mamadouxxx/shield_u575/fabrication/v1/assemblage/shield_u575_BOM_JLCPCB.csv

Comment | Designator | Footprint | LCSC Part #
1uF 0805 | C1,C2,C5,C9 | 0805
100nF 0805 | C3,C6,C8 | 0805
4.7uF 0805 | C4 | 0805
10uF 0805 | C7 | 0805
56k 0805 | R1,R2 | 0805
100k 0805 | R3,R10 | 0805
10k 0805 | R5 | 0805
4.7k 0805 | R6,R7,R8,R9 | 0805
TPS22810DBVR | U2 | SOT-23-6
