mamadouxxx/shield_u575/SCD30/SCD30.step

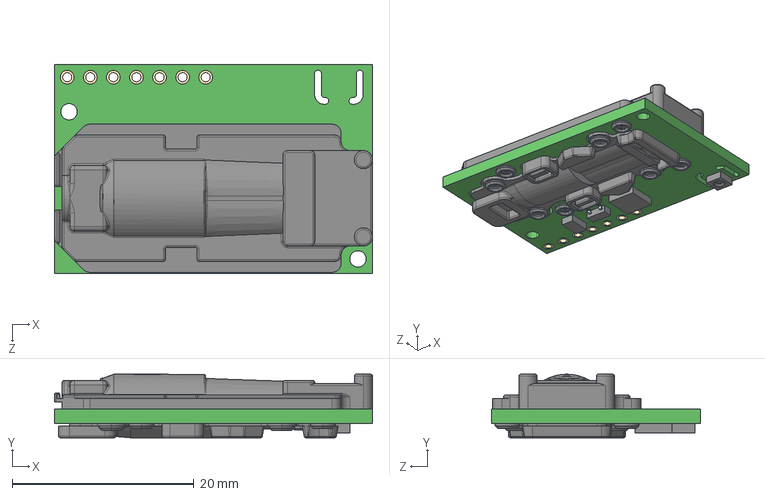
[picture p3: CAD file, 2026-11-06]
SCD30/SCD30.step
35.0 x 7.00 x 23.0 mm
