mamadouxxx/shield_u575/TPS22810DBVR/TPS22810DBVR.step

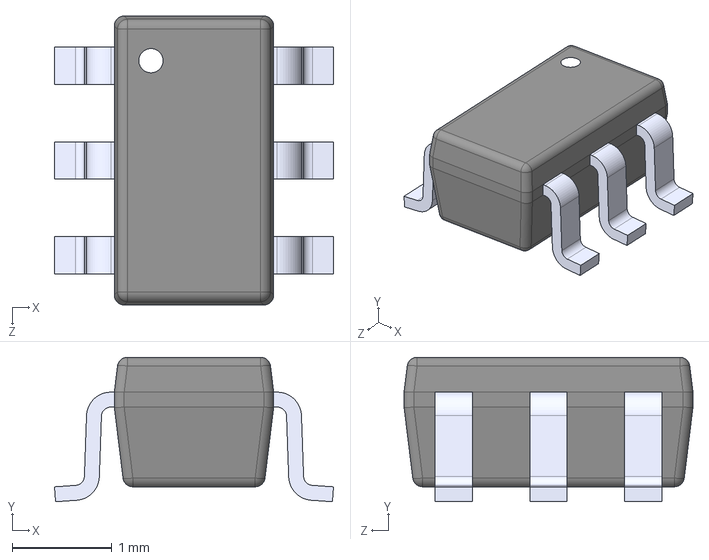
[picture p4: CAD file, 2026-11-06]
TPS22810DBVR/TPS22810DBVR.step
2.80 x 1.45 x 2.90 mm
