mamadouxxx/shield_u575/schema.pdf

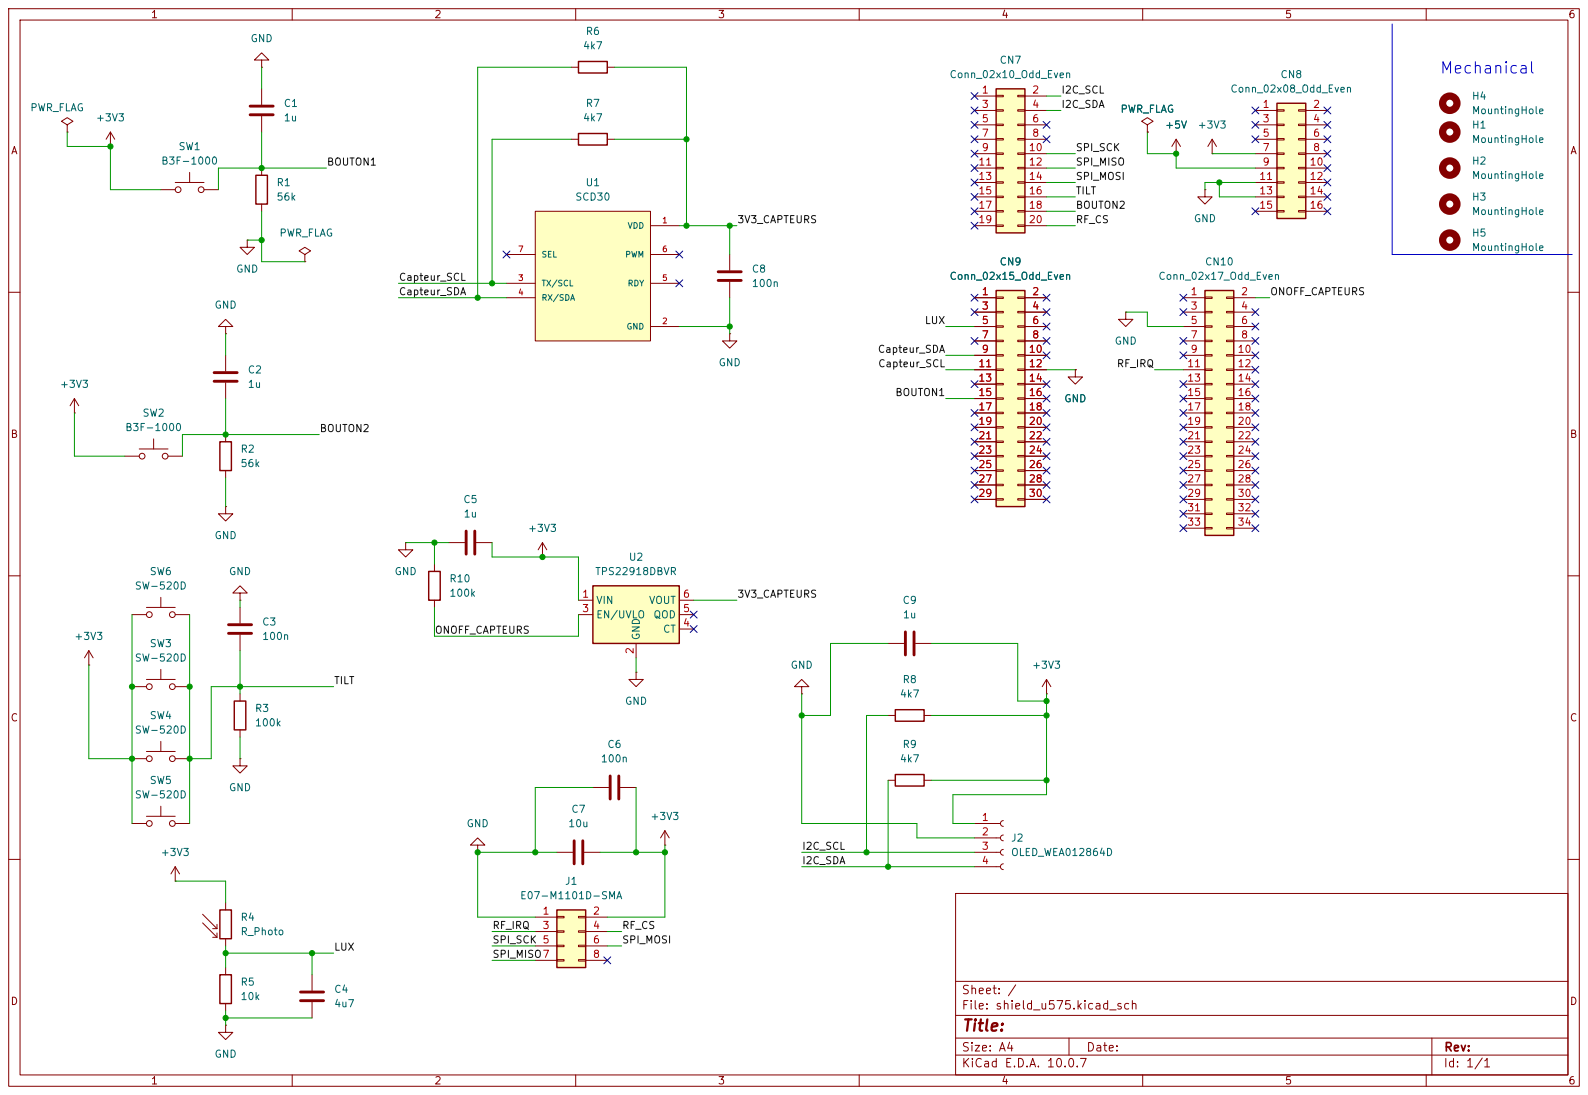
[picture p5: page 1]

Size: A4 | Rev:
KiCad E.D.A. 10.0.7 | Id: 1/1
