mamadouxxx/shield_u575/shield_u575.kicad_pcb

## KiCad design shield_u575.kicad_pcb (2026-11-09)

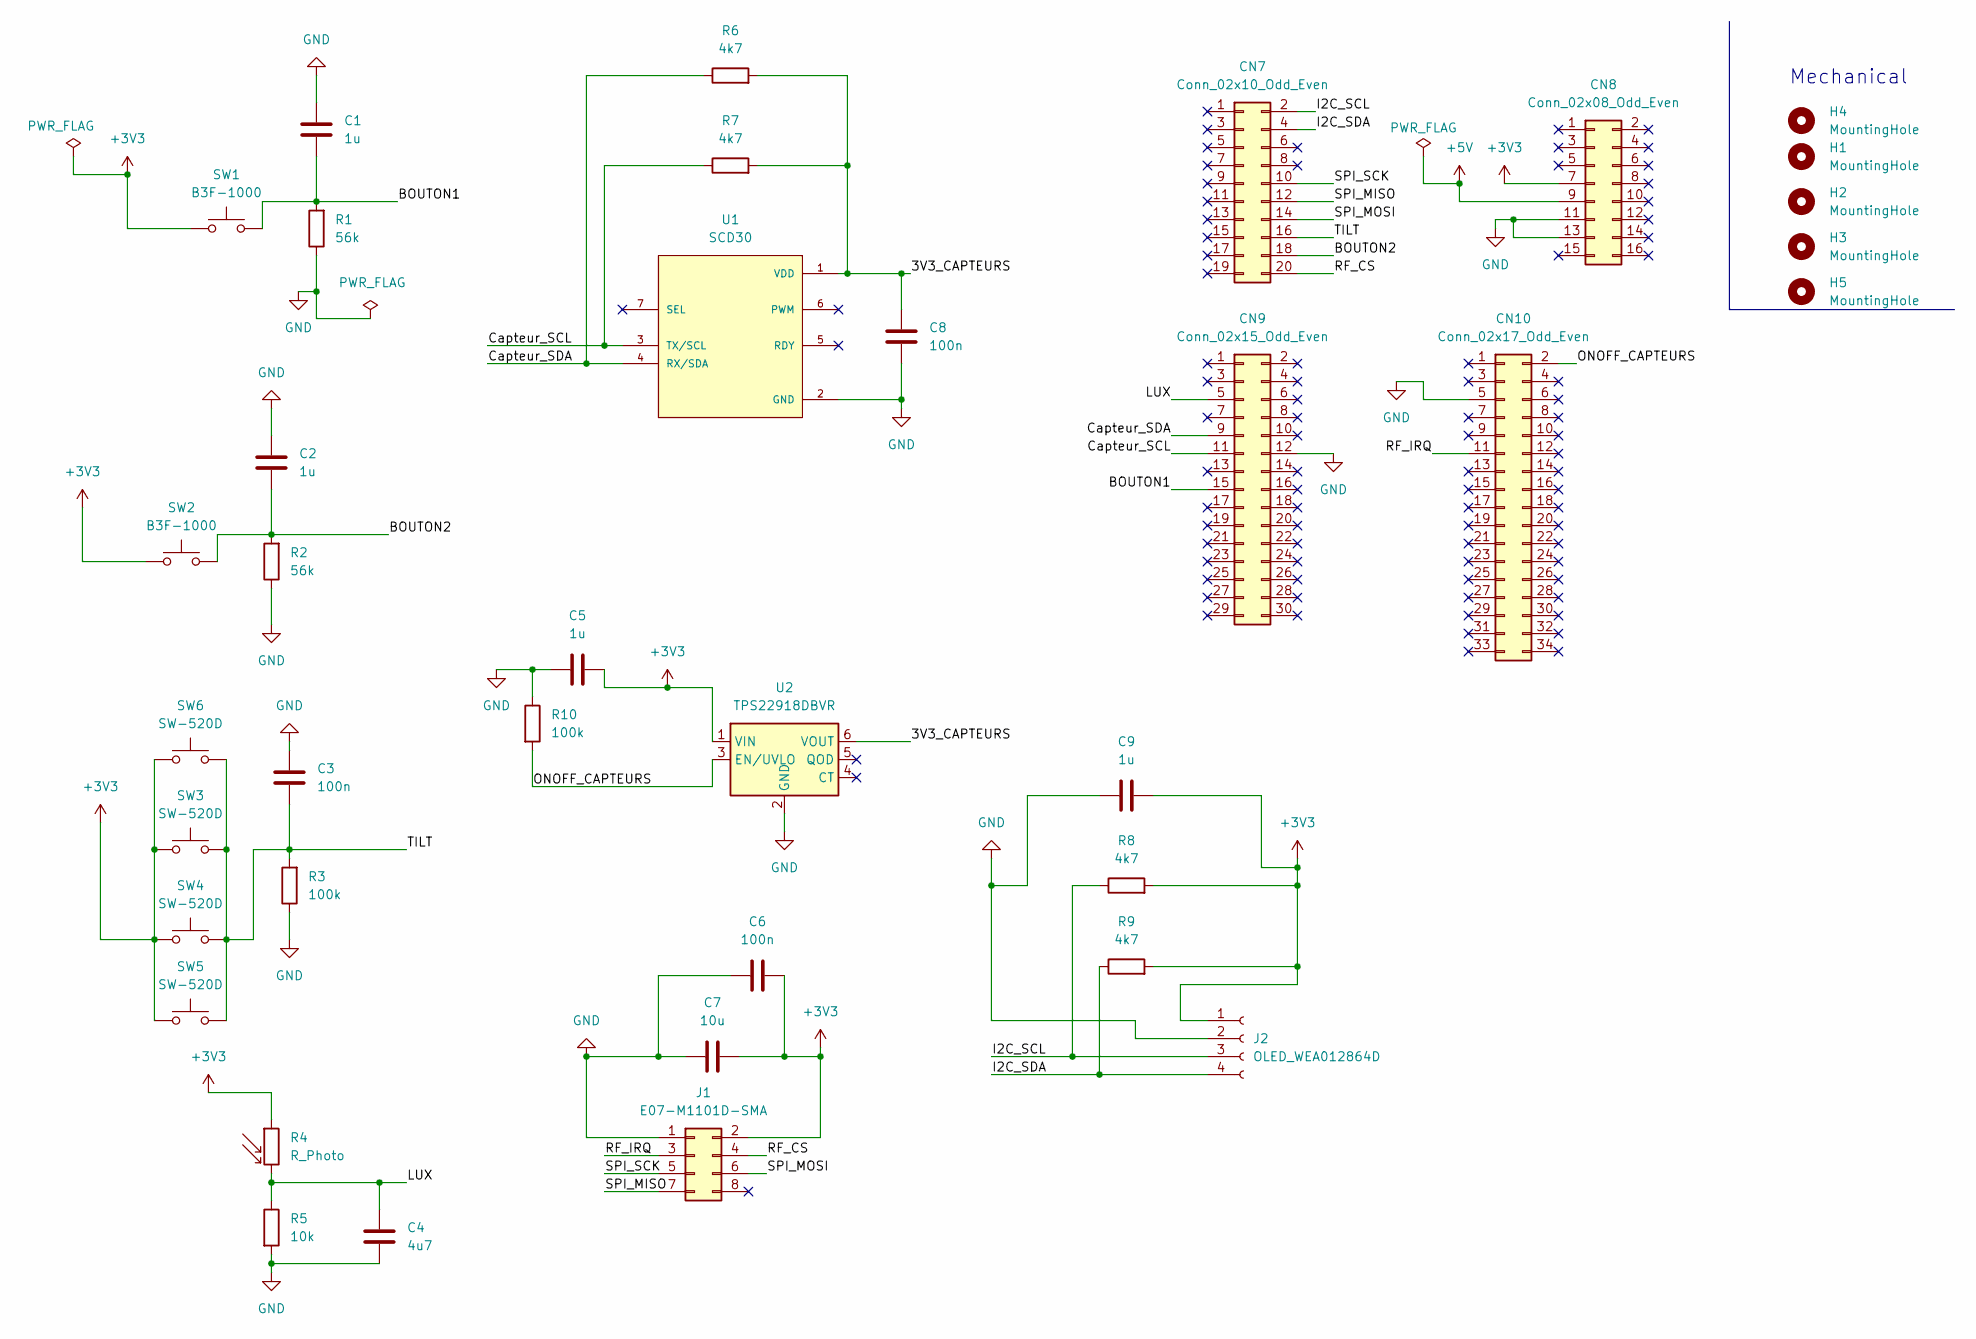
[picture p6: schematic shield_u575.kicad_sch]

Parts:
C1, C2, C5, C9: 1u; C_0805_2012Metric
C3, C6, C8: 100n; C_0805_2012Metric
C4: 4u7; C_0805_2012Metric
C7: 10u; C_0805_2012Metric
CN7: Conn_02x10_Odd_Even; PinHeader_2x10_P2.54mm_Vertical
CN8: Conn_02x08_Odd_Even; PinHeader_2x08_P2.54mm_Vertical
CN9: Conn_02x15_Odd_Even; PinHeader_2x15_P2.54mm_Vertical
CN10: Conn_02x17_Odd_Even; PinHeader_2x17_P2.54mm_Vertical
H1, H2, H3, H4, H5: MountingHole; MountingHole_3.2mm_M3
J1: E07-M1101D-SMA; PinHeader_2x04_P2.54mm_Vertical
J2: OLED_WEA012864D; PinSocket_1x04_P2.54mm_Vertical
R1, R2: 56k; R_0805_2012Metric
R3, R10: 100k; R_0805_2012Metric
R4: R_Photo; R_LDR_5.0x4.1mm_P3mm_Vertical
R5: 10k; R_0805_2012Metric
R6, R7, R8, R9: 4k7; R_0805_2012Metric
SW1, SW2: B3F-1000; SW_PUSH_6mm_H4.3mm
SW3, SW4, SW5, SW6: SW-520D; PinHeader_1x02_P2.54mm_Vertical
U1: SCD30; PinSocket_1x07_P2.54mm_Vertical; PARTREV D1
U2: TPS22918DBVR; SOT-23-6

Connections:
+3V3: C5.2, C6.1, C7.2, C9.1, CN8.7, J1.2, J2.1, R4.1, R8.2, R9.2, SW1.1, SW2.1, SW3.1, SW4.1, SW5.1, SW6.1, U2.1 (VIN)
+5V: CN8.9
/3V3_CAPTEURS: C8.1, R6.2, R7.2, U1.1 (VDD), U2.6 (VOUT)
/BOUTON1: C1.2, CN9.15, R1.2, SW1.2
/BOUTON2: C2.2, CN7.18, R2.2, SW2.2
/Capteur_SCL: CN9.11, R7.1, U1.3 (TX/SCL)
/Capteur_SDA: CN9.9, R6.1, U1.4 (RX/SDA)
/I2C_SCL: CN7.2, J2.3, R8.1
/I2C_SDA: CN7.4, J2.4, R9.1
/LUX: C4.1, CN9.5, R4.2, R5.1
/ONOFF_CAPTEURS: CN10.2, R10.2, U2.3 (EN/UVLO)
/RF_CS: CN7.20, J1.4
/RF_IRQ: CN10.11, J1.3
/SPI_MISO: CN7.12, J1.7
/SPI_MOSI: CN7.14, J1.6
/SPI_SCK: CN7.10, J1.5
/TILT: C3.2, CN7.16, R3.2, SW3.2, SW4.2, SW5.2, SW6.2
GND: C1.1, C2.1, C3.1, C4.2, C5.1, C6.2, C7.1, C8.2, C9.2, CN8.11, CN8.13, CN9.12, CN10.5, J1.1, J2.2, R1.1, R2.1, R3.1, R5.2, R10.1, U1.2 (GND), U2.2 (GND)

Notes on the sheet:
Mechanical

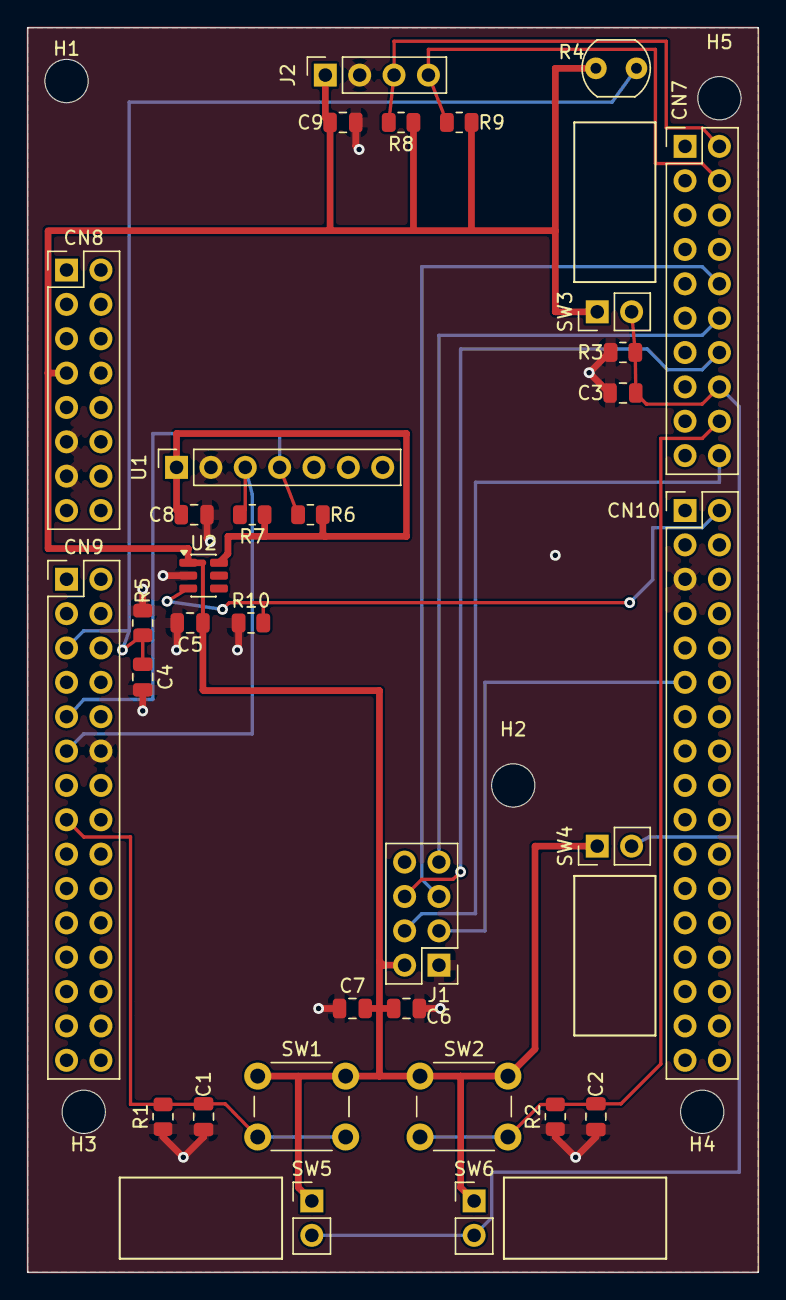
[picture p7: board shield_u575.kicad_pcb from above]

Board: 2 copper layers, 54.0 x 92.0 mm, 38 parts (0 on the bottom side), 17 nets.
