mamadouxxx/shield_u575/(commit log)

2026-11-06 Initial commit: état du projet au 06/11/2026
    [SCD30.step, TPS22810DBVR.step, shield_u575.kicad_pcb, shield_u575.kicad_sch]
2026-11-07 Ajout README, vue 3D, schéma PDF et routage des boutons
    [shield_u575.kicad_pcb]
2026-11-07 Routage terminé, DRC propre
    - Familles 1 à 3 (boutons, SCD30, écran), radio, TILT, LUX routés
    - Zone GND sur F.Cu + via de couture (147 ; 103)
    - 3 starved_thermal exclues (PTH reliées par l'autre face)
    - Sérigraphie nettoyée
    [shield_u575.kicad_pcb]
2026-11-08 updt filling zones, ploting pdf
    [shield_u575.kicad_pcb]
2026-11-09 Fichiers de fabrication V1 et passage au TPS22918
    - Ajout des Gerber, du perçage, de la BOM et du fichier de positions (fabrication/v1)
    - U2 : TPS22810 remplacé par TPS22918 (même boîtier, même brochage)
    - Mise à jour du schéma PDF, de la vue 3D et ajout de la vue Gerber
    [shield_u575-B_Cu.gbl, shield_u575-B_Mask.gbs, shield_u575-B_Silkscreen.gbo, shield_u575-Edge_Cuts.gm1, shield_u575-F_Cu.gtl, shield_u575-F_Mask.gts, shield_u575-F_Paste.gtp, shield_u575-F_Silkscreen.gto]
2026-11-09 Ajout de la licence CERN-OHL-P v2
